Goldixan/USPAC/Photos/BlinkLEDCircuitFin.jpg

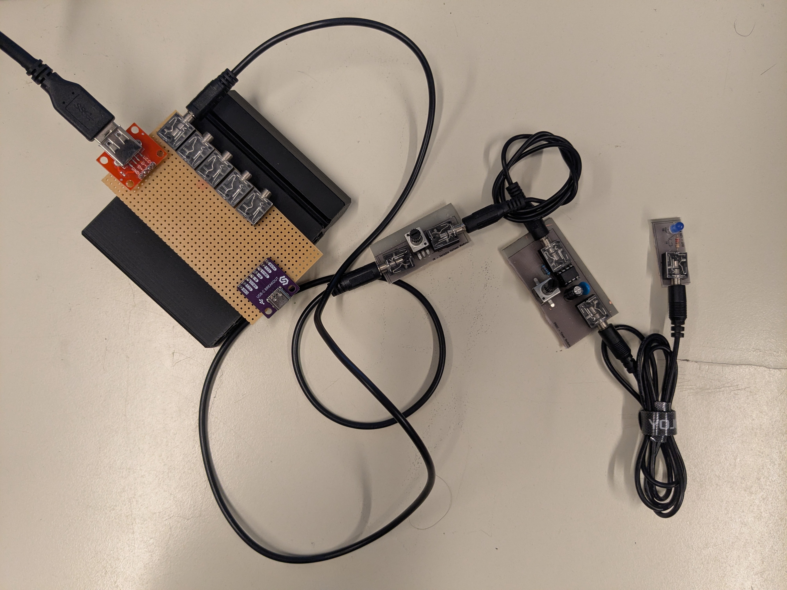
Photos/BlinkLEDCircuitFin.jpg
