Goldixan/USPAC/Photos/ALLES.jpg

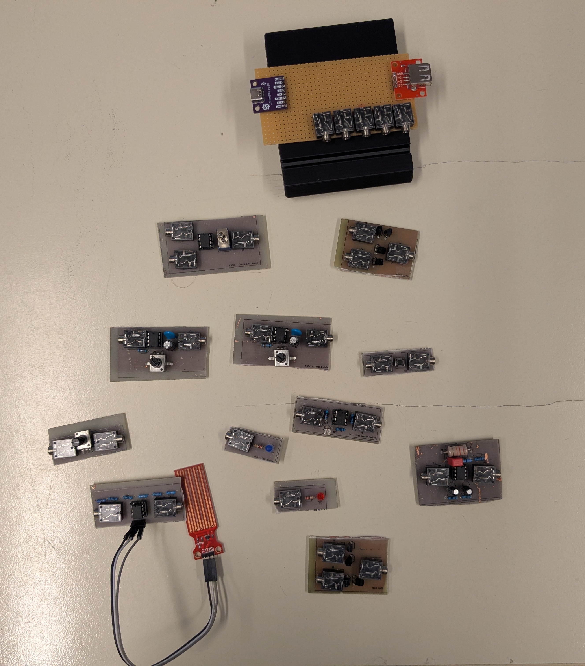
Photos/ALLES.jpg
