Goldixan/USPAC/Etching/etching_1.jpg

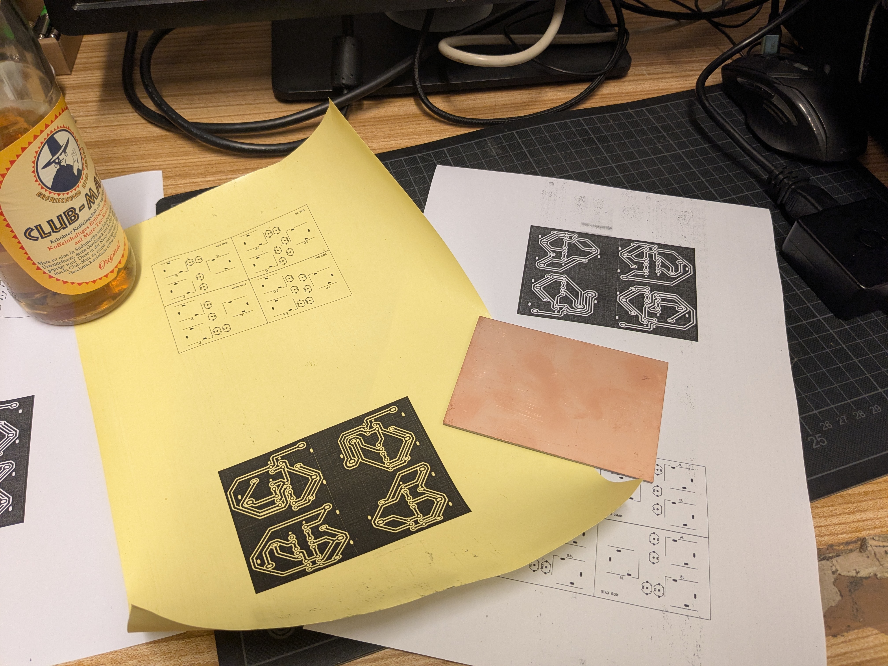
Etching/etching_1.jpg
