Goldixan/USPAC/Etching/etching_2.jpg

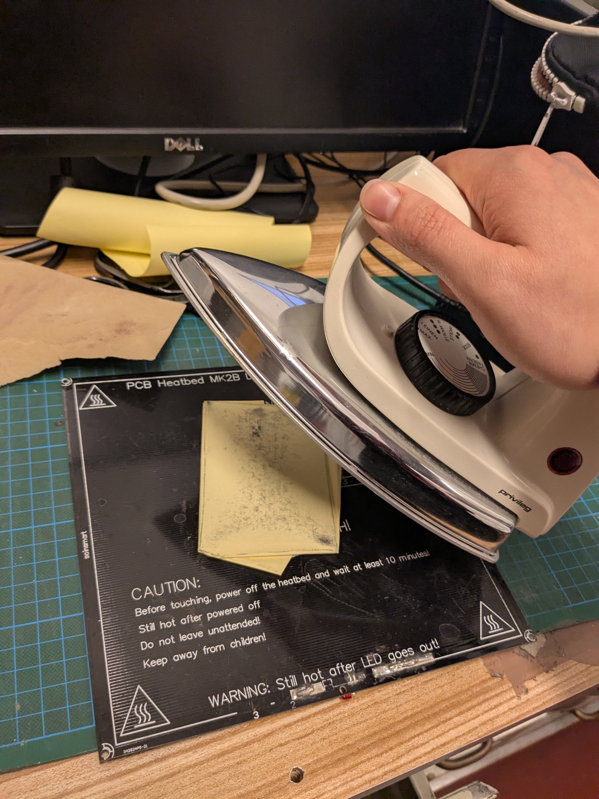
Etching/etching_2.jpg
