Goldixan/USPAC/Etching/etching_3.jpg

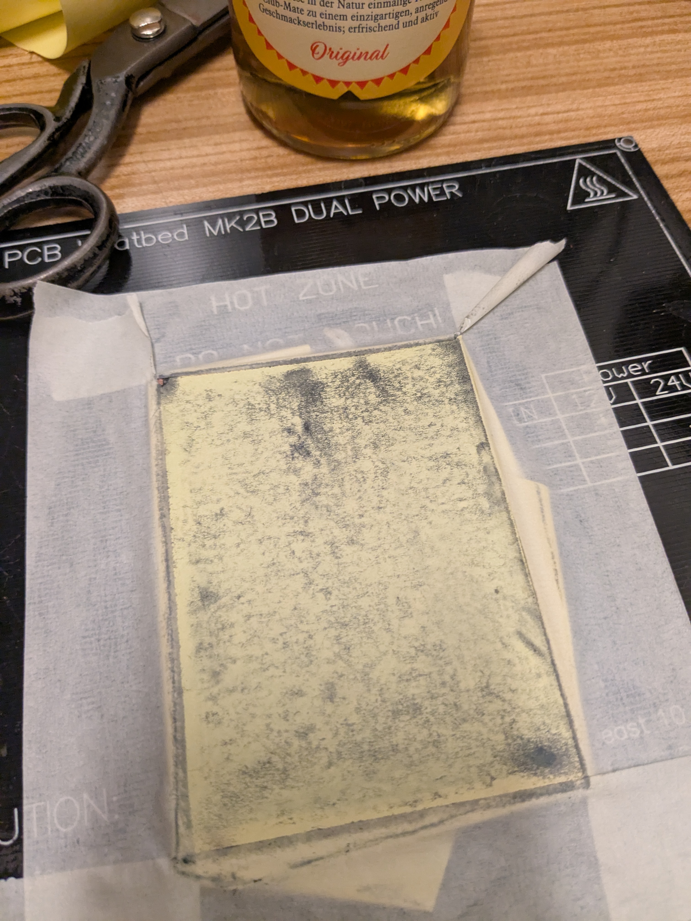
Etching/etching_3.jpg
