Goldixan/USPAC/Etching/etching_4.jpg

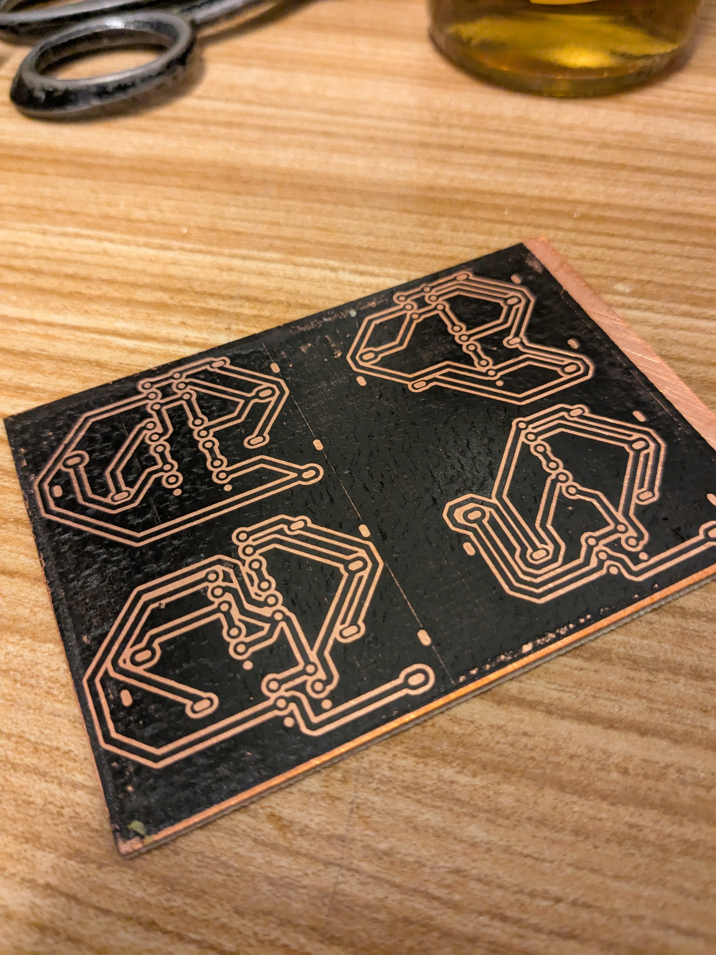
Etching/etching_4.jpg
