Goldixan/USPAC/Etching/etching_5.jpg

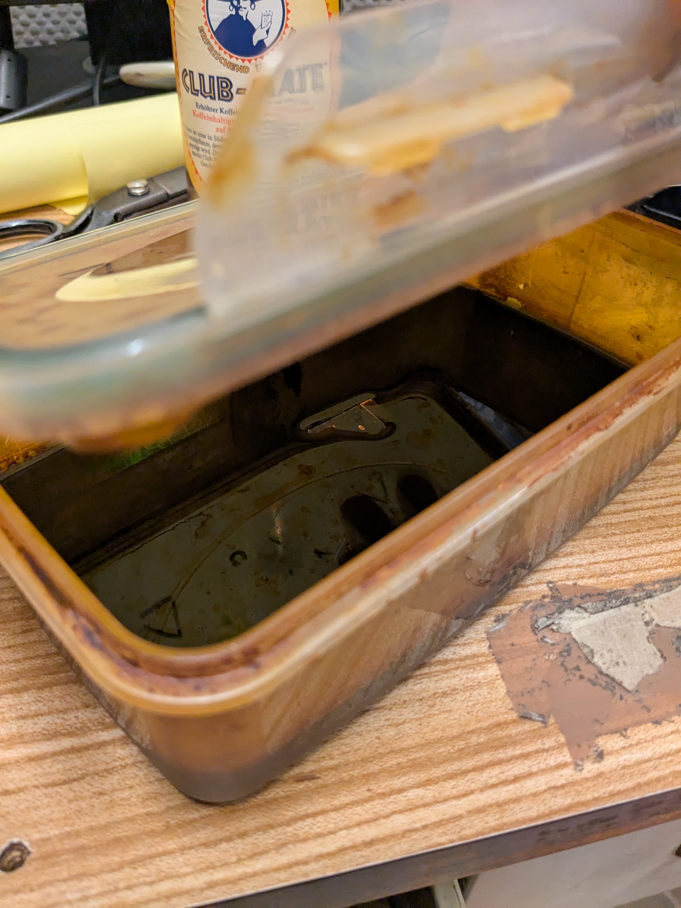
Etching/etching_5.jpg
