Goldixan/USPAC/Etching/etching_6.jpg

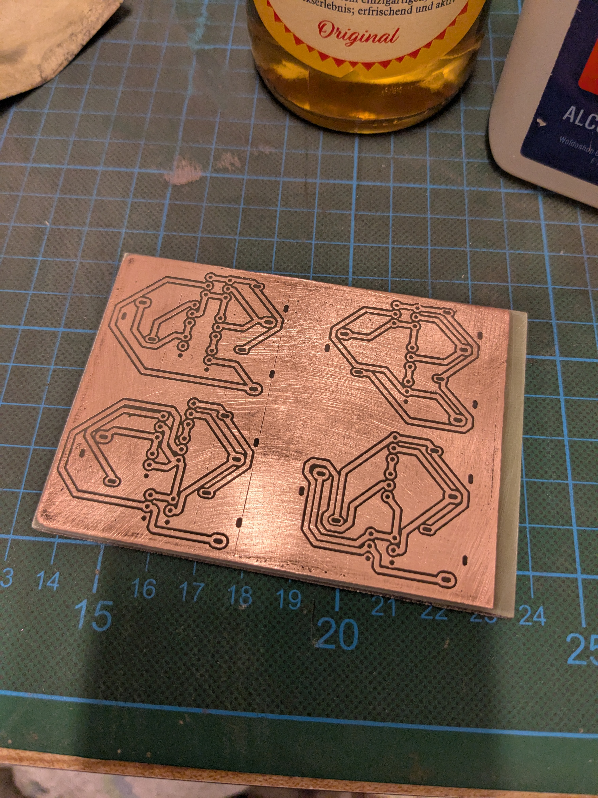
Etching/etching_6.jpg
