Goldixan/USPAC/Etching/etching_7.jpg

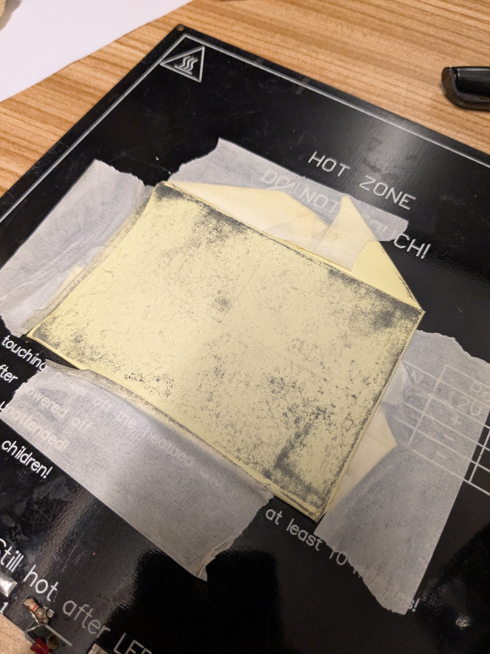
Etching/etching_7.jpg
