Goldixan/USPAC/Etching/etching_8.jpg

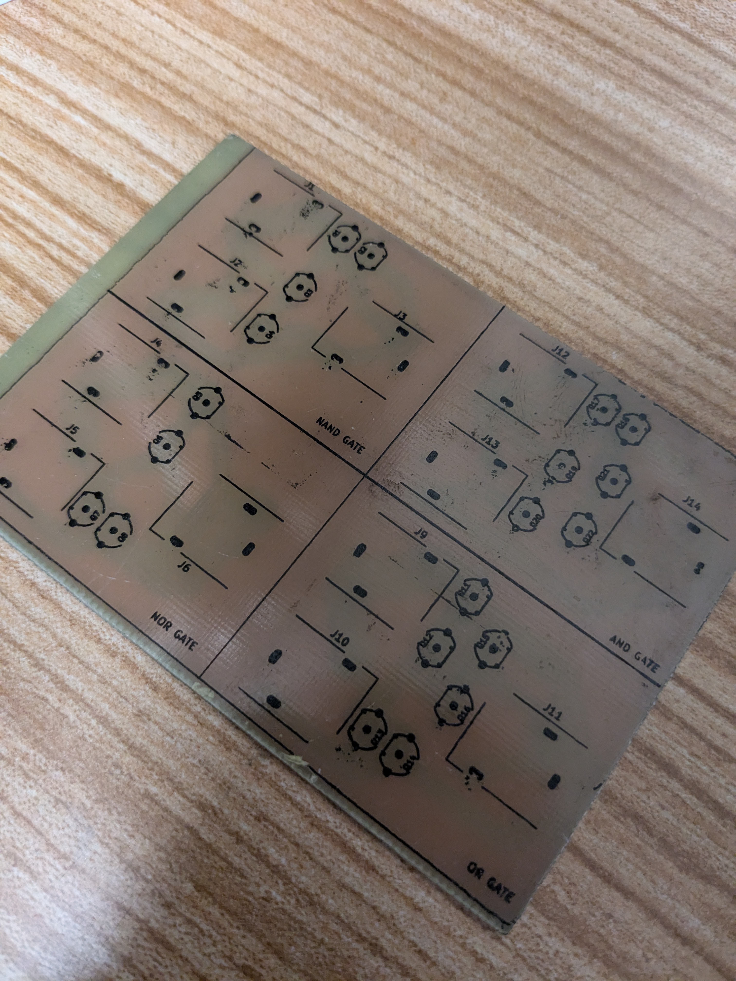
Etching/etching_8.jpg
