Goldixan/USPAC/Etching/etching_9.jpg

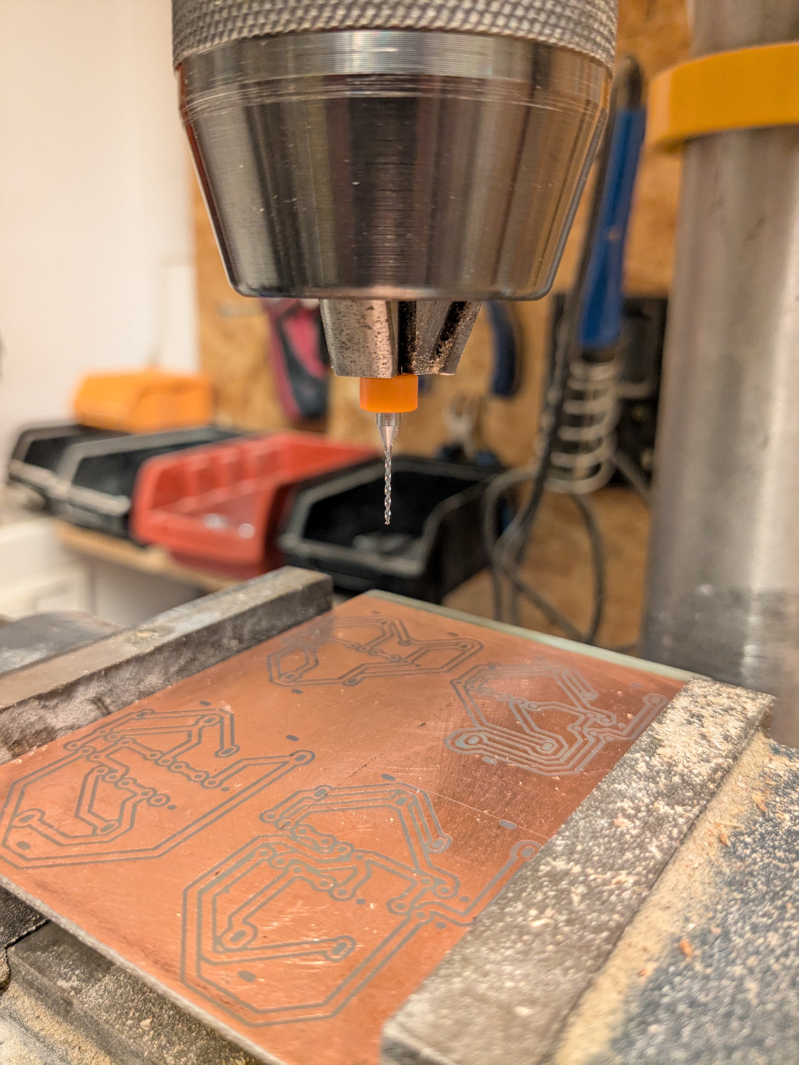
Etching/etching_9.jpg
