Goldixan/USPAC/Etching/etching_10.jpg

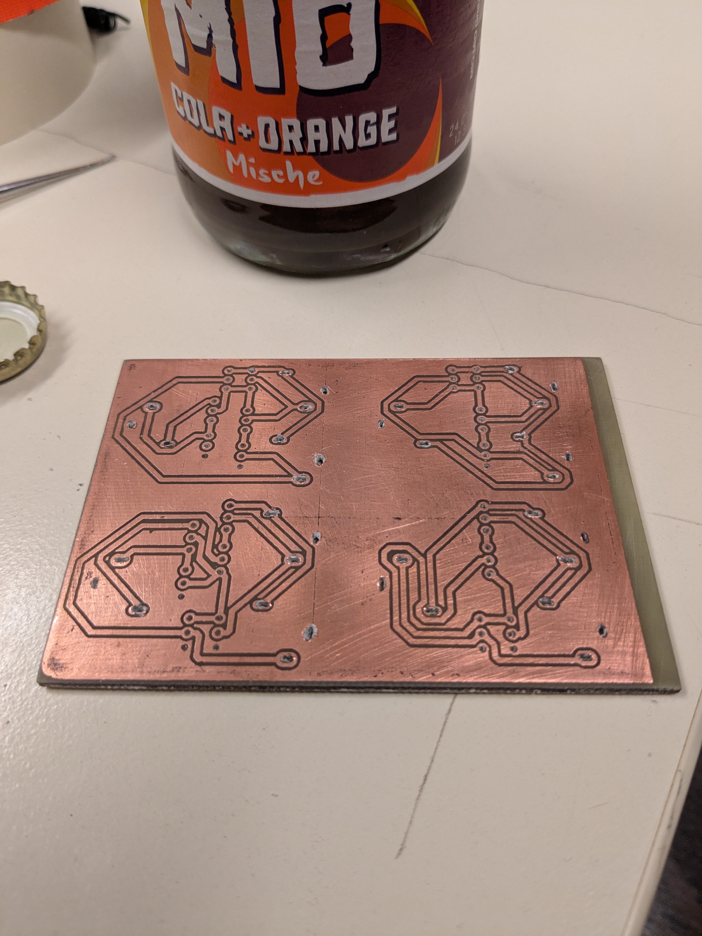
Etching/etching_10.jpg
