Goldixan/USPAC/Photos/Banana.jpg

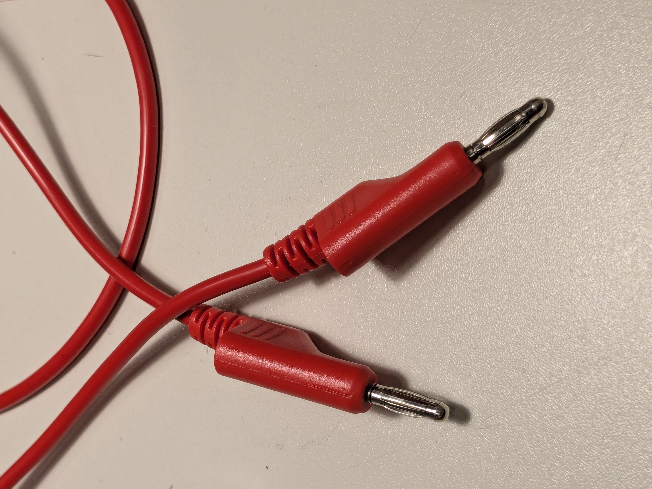
Photos/Banana.jpg
