Goldixan/USPAC/Shematics/IN/INPUT - Variable Voltage Module.png

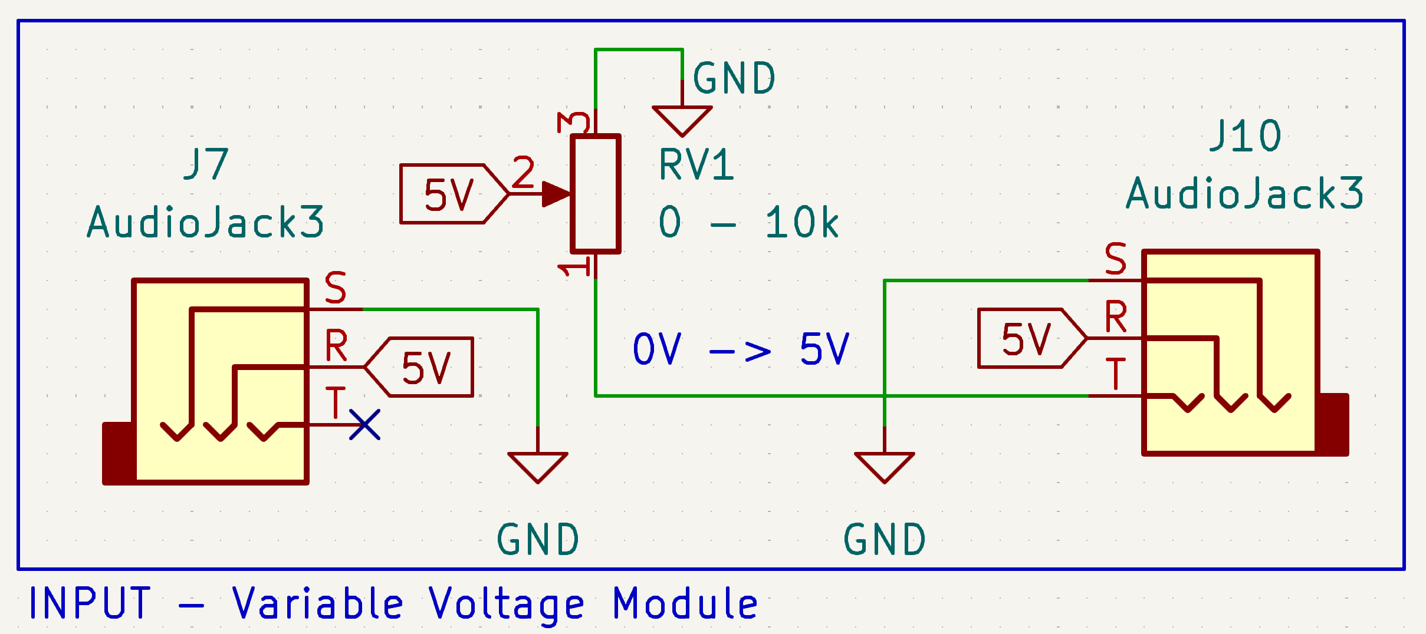
Shematics/IN/INPUT - Variable Voltage Module.png
