Goldixan/USPAC/Shematics/IN/WaterlevelSensor.png

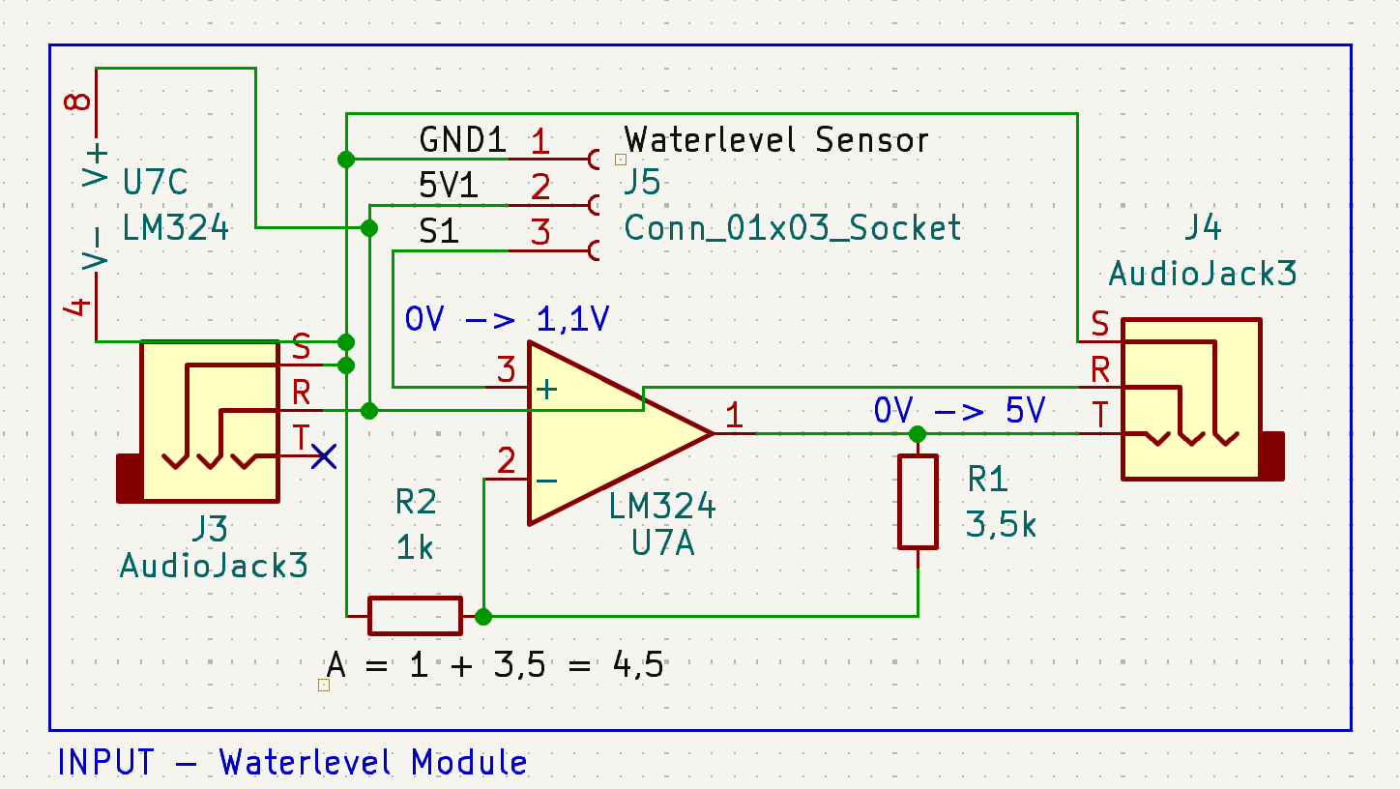
Shematics/IN/WaterlevelSensor.png
