Goldixan/USPAC/Shematics/OUT/OUT - Speaker Module.png

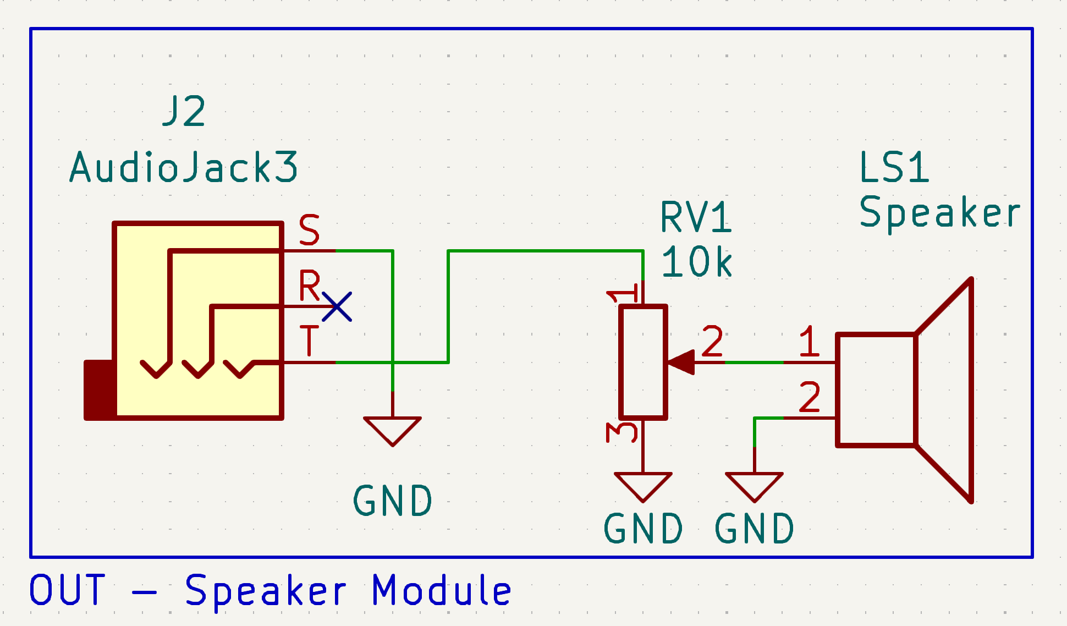
Shematics/OUT/OUT - Speaker Module.png
