Goldixan/USPAC/Shematics/PROC/Comparator Module.PNG

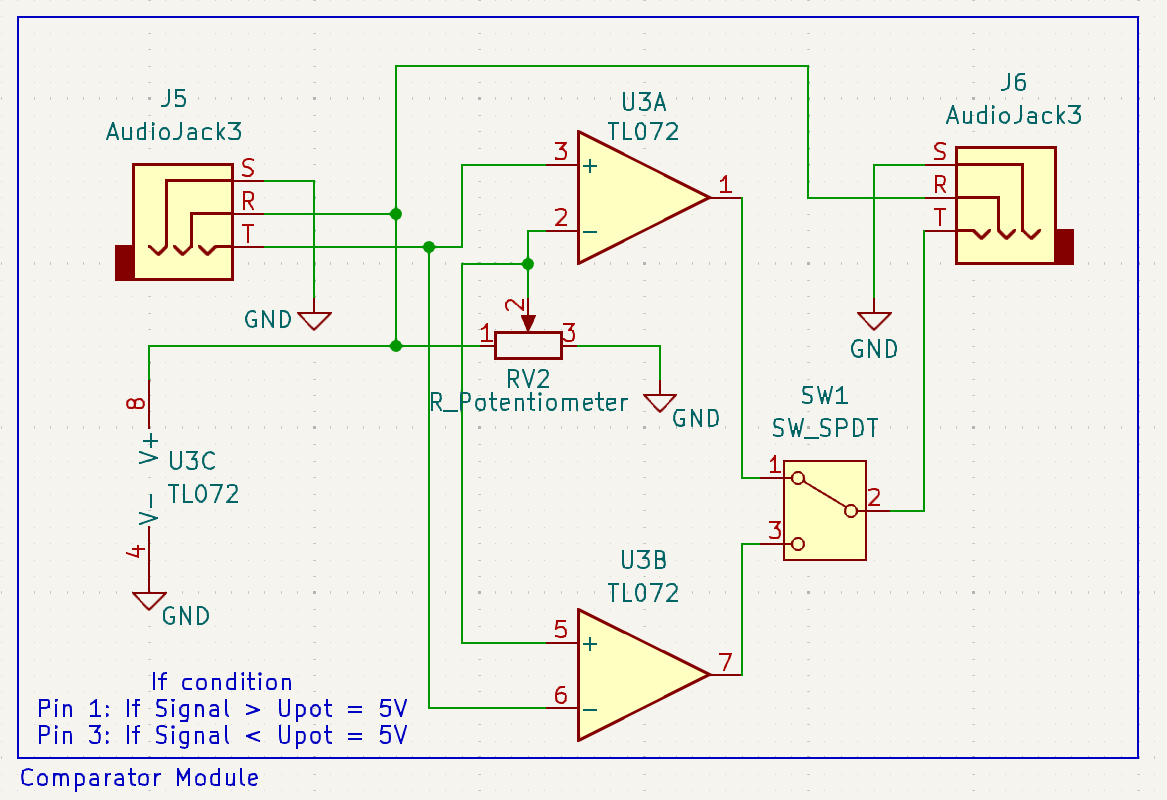
Shematics/PROC/Comparator Module.PNG
