Goldixan/USPAC/Shematics/PROC/PROC - AC to DC Module.png

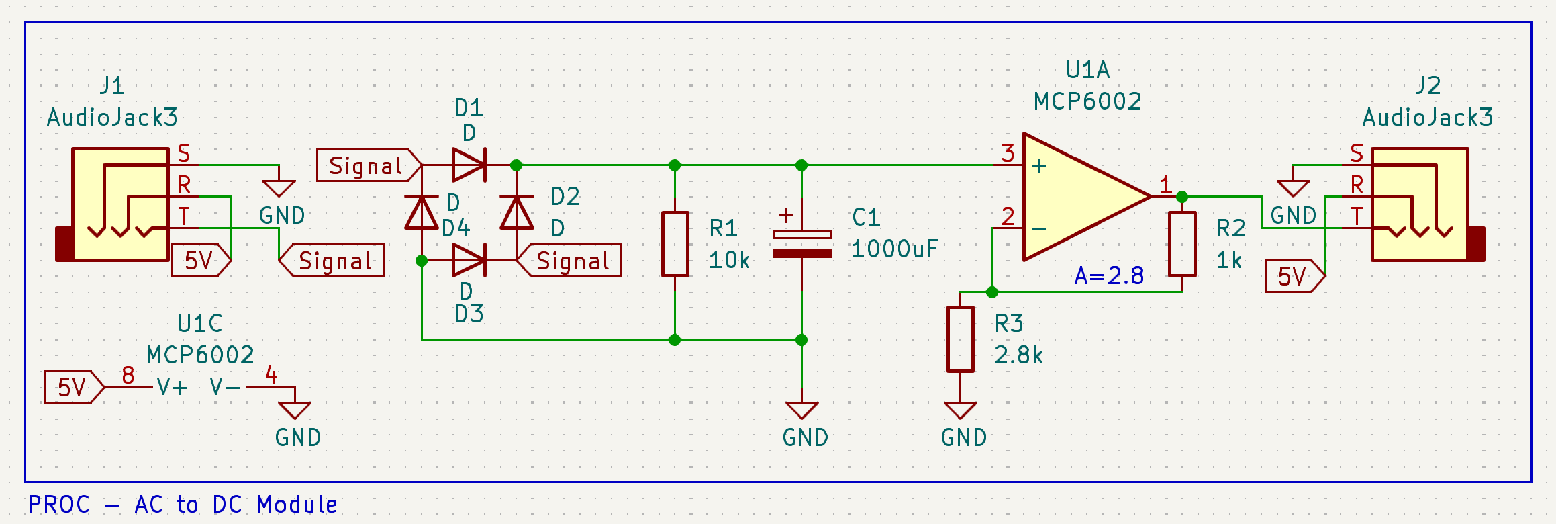
Shematics/PROC/PROC - AC to DC Module.png
