Goldixan/USPAC/Shematics/PROC/PROC - Comparator Module.png

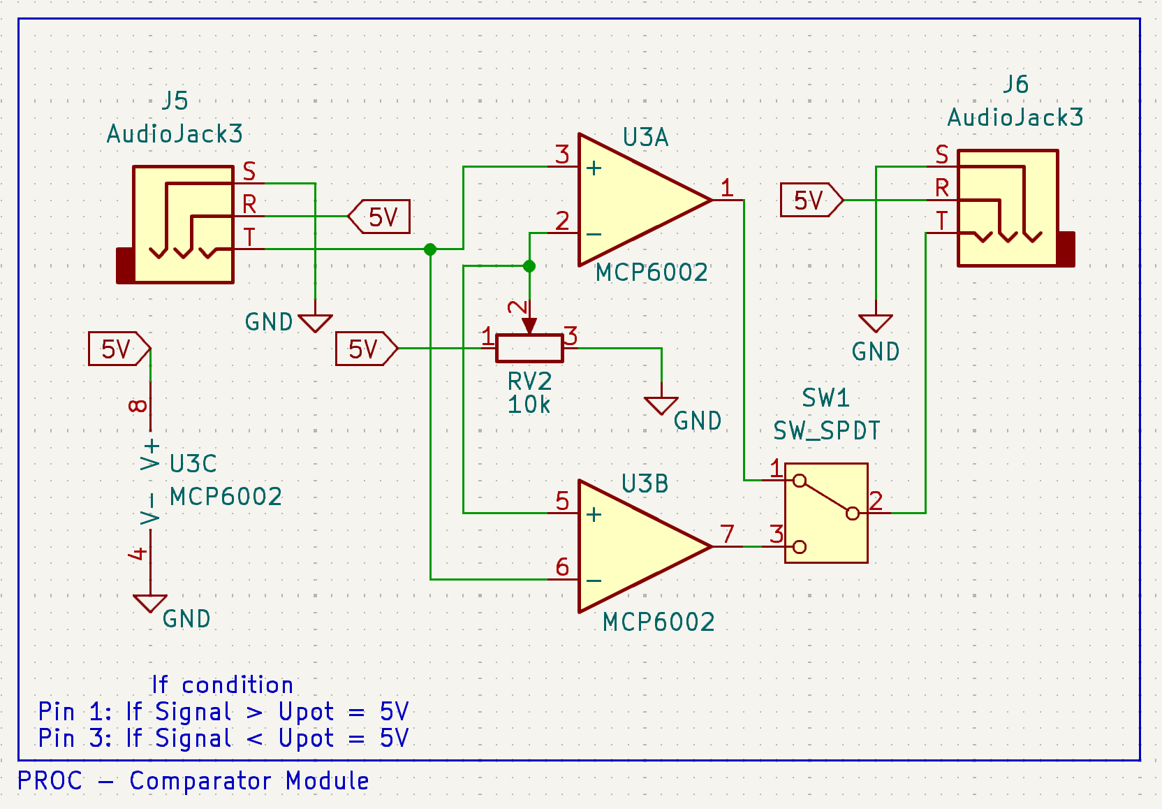
Shematics/PROC/PROC - Comparator Module.png
