Goldixan/USPAC/Shematics/PROC/PROC - Comparator Module_fixed.png

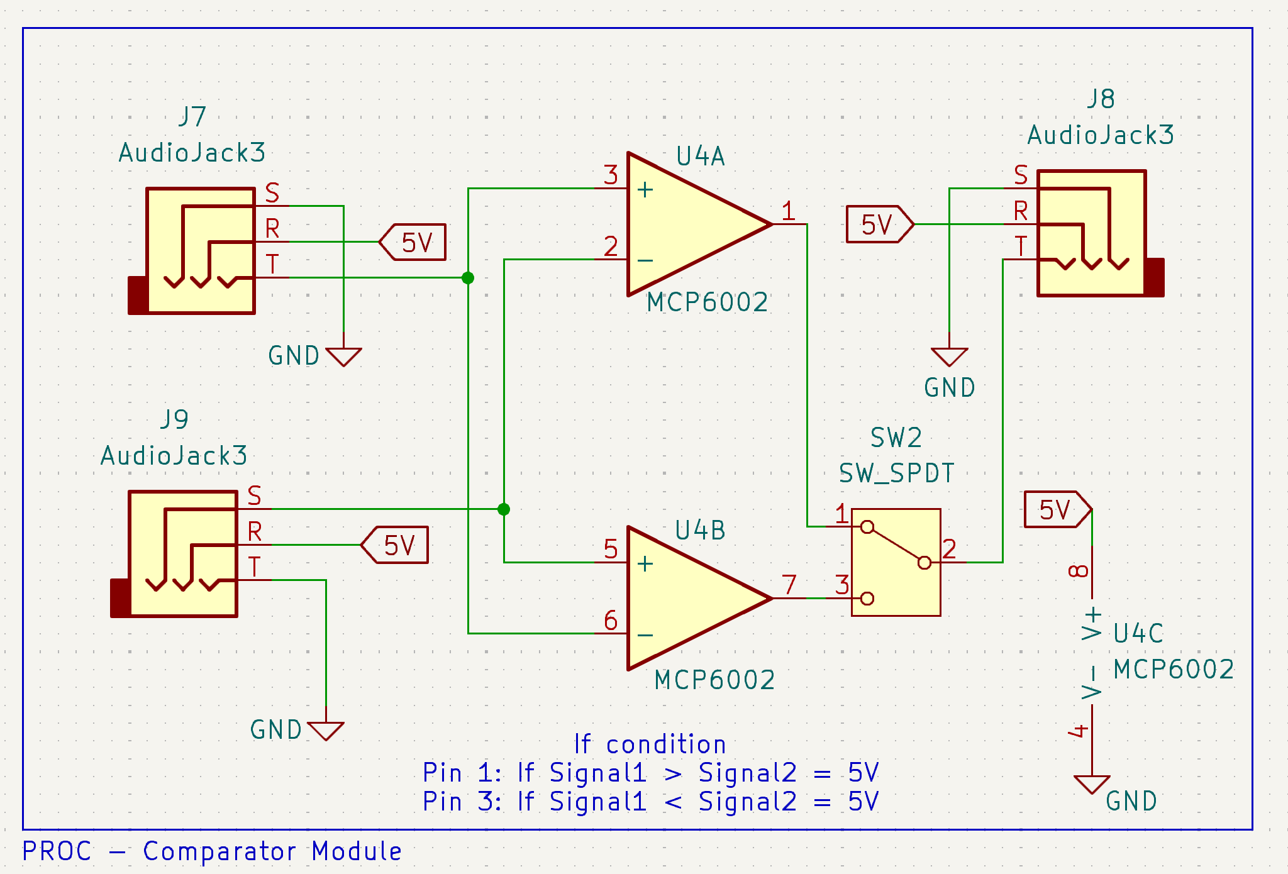
Shematics/PROC/PROC - Comparator Module_fixed.png
