Goldixan/USPAC/Shematics/PROC/PROC - Timer Module.png

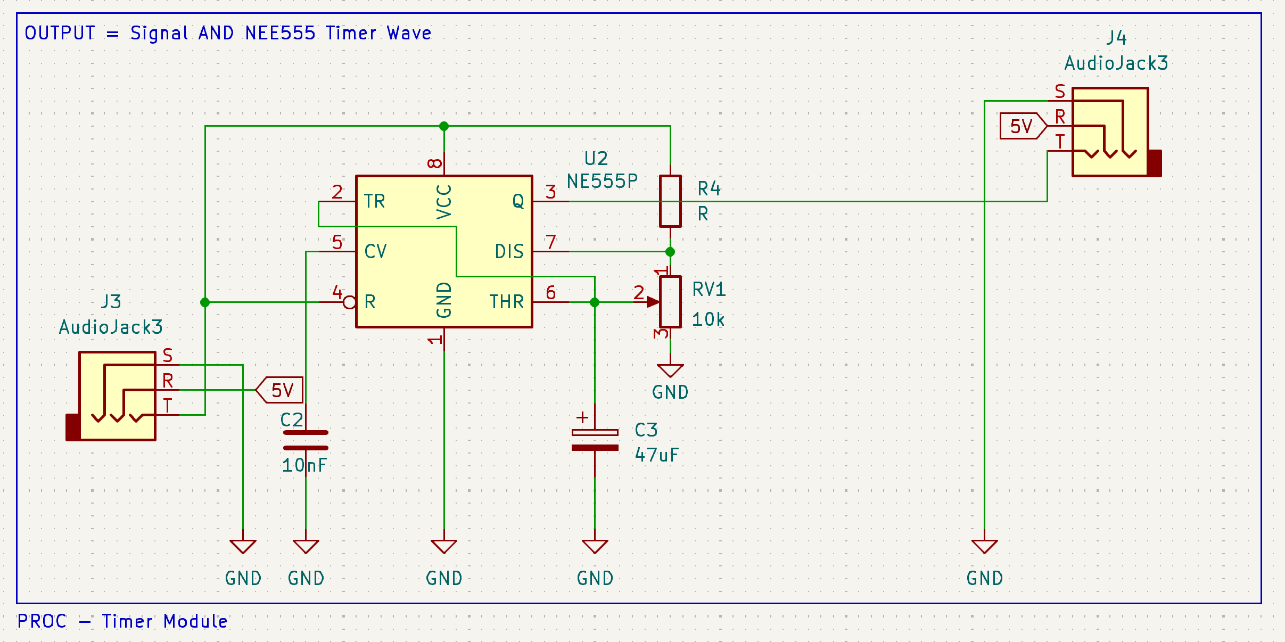
Shematics/PROC/PROC - Timer Module.png
