Goldixan/USPAC/Shematics/PROC/PROC - Timer Module_fixed2.png

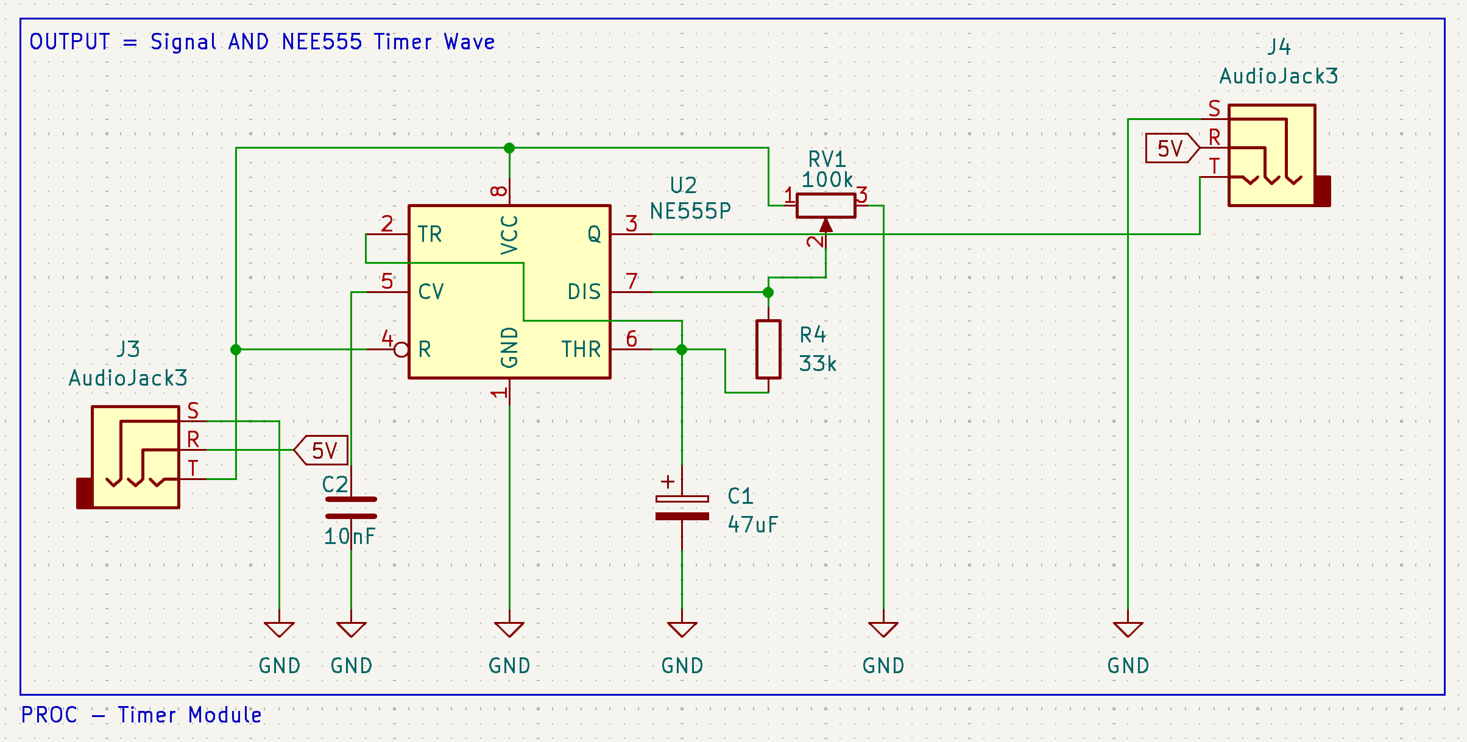
Shematics/PROC/PROC - Timer Module_fixed2.png
