Goldixan/USPAC/LTSpice Simulations/JFET VCR/Draft1.asc

J1: njf
R1: res; 500
V1: voltage; 5
V2: voltage; -5
Named nets: 0, VOUT
.tran 1
