Goldixan/USPAC/LTSpice Simulations/LC Schwingkreis mit Messbrücke/Draft1.asc

C1: cap; 2.2µF
C3: polcap; 1000µF
D1: diode
D2: diode
D3: diode
D4: diode
L1: ind; 100mH
R2: res; 10k
V1: voltage; SINE(0 2.5 50)
Named nets: 0, out
.tran 1
.ic v(out)=1
