Goldixan/USPAC/LTSpice Simulations/LC Schwingkreis mit Messbrücke/Draft2.asc

C1: polcap; 47µF
C2: cap; 10nF
R1: res; 100
R2: res; 33k
R3: res; 10
U1: NE555
V1: voltage; 5
Named nets: 0
.tran 10
