Goldixan/USPAC/LTSpice Simulations/NE555/Draft2.asc

C1: polcap; 47µF
C2: cap; 10nF
R1: res; 100
R2: res; 33k
R3: res; 100k
U1: NE555
V1: voltage; SINE(0 5 1)
Named nets: 0
.tran 10
