Goldixan/USPAC/LTSpice Simulations/CMOS/Inverter/Inverter.asc

M1: nmos
M2: pmos
V1: voltage; 1
V2: voltage; PULSE(0 1 0 0 0 20m 40m)
Named nets: 0
.tran 200m
PMOS must be mirrored and rotated by 180, Drain and Source are WRONG otherwise
