Goldixan/USPAC/LTSpice Simulations/CMOS/NOR/Draft1.asc

M1: pmos
M2: nmos
M3: pmos
M4: nmos
V1: voltage; PULSE(0 1 0 0 0 20m 40m)
V2: voltage; PULSE(0 1 20m 0 0 20m 40m)
V3: voltage; 1
Named nets: 0, OUT, X1, X2
.tran 200m
