Goldixan/USPAC/KiCadSchematics/PROC/Verarbeitung/Verarbeitung.kicad_pcb

## KiCad design KiCadSchematics/PROC/Verarbeitung/Verarbeitung.kicad_pcb (2026-04-08)

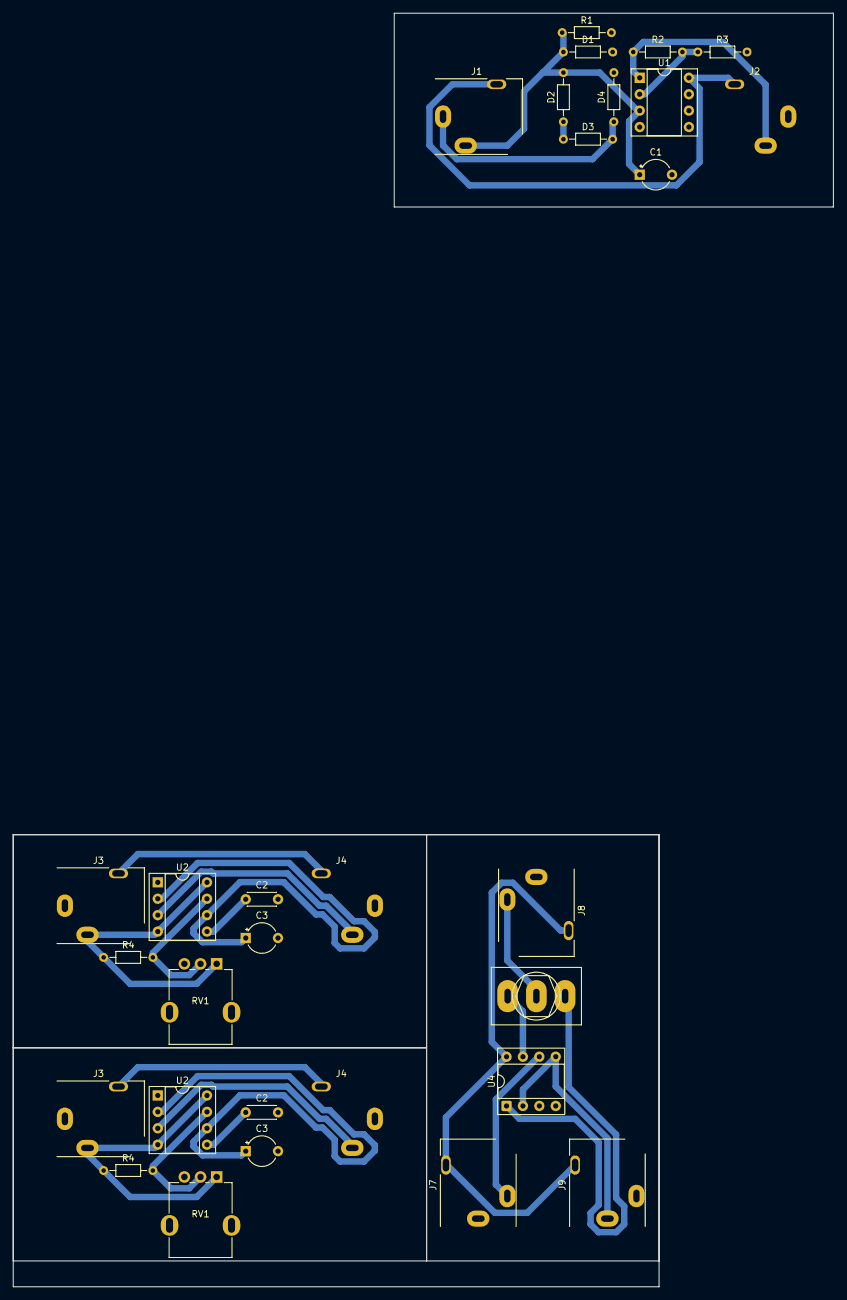
[picture p51: board Verarbeitung.kicad_pcb from above]

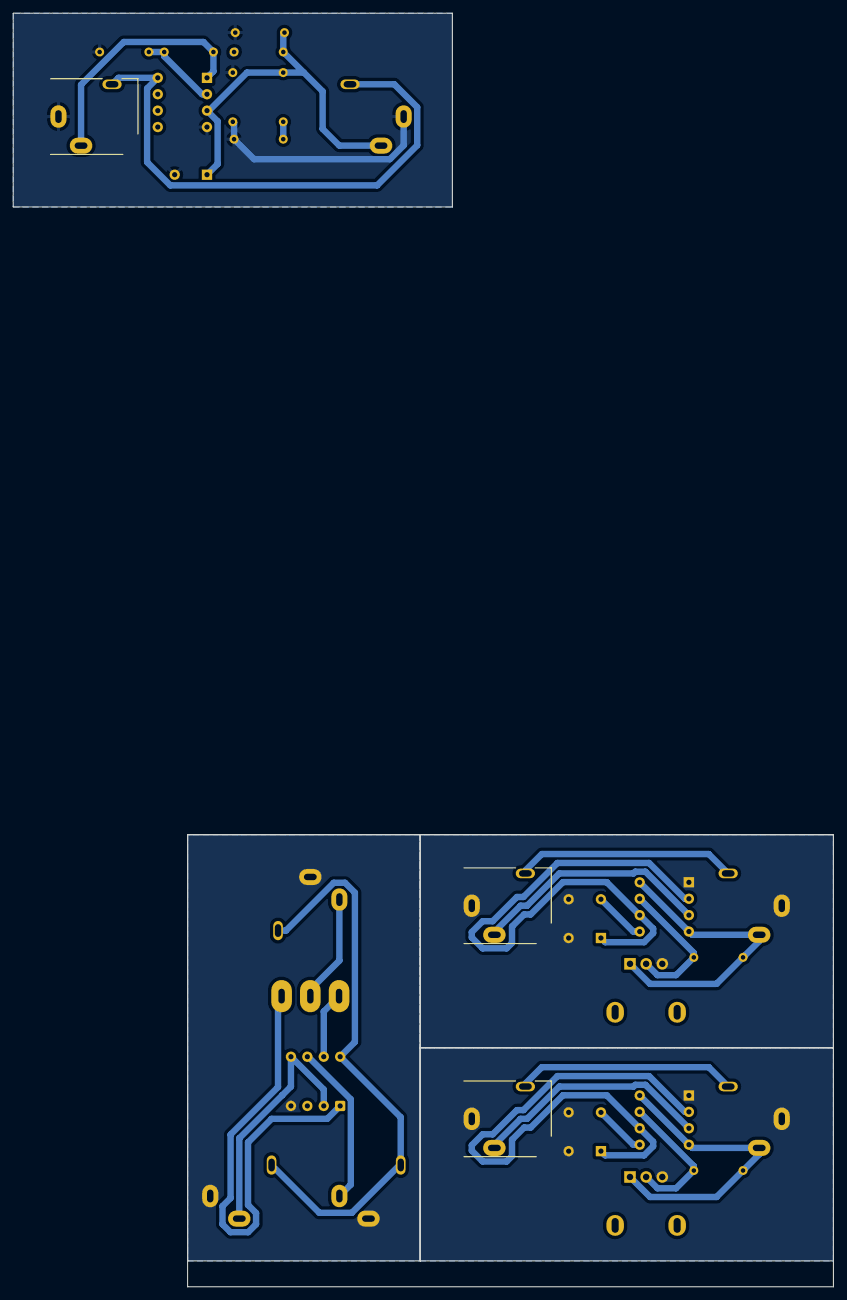
[picture p52: board Verarbeitung.kicad_pcb from below]

Board: 2 copper layers, 127.0 x 197.2 mm, 30 parts (3 on the bottom side), 17 nets.

Parts:
C1: 1000uF; CP_Radial_Tantal_D4.5mm_P5.00mm
C2, C2#2: 10nF; C_Disc_D4.3mm_W1.9mm_P5.00mm
C3, C3#2: 47uF; CP_Radial_Tantal_D4.5mm_P5.00mm
D1, D2, D3, D4: D; R_Axial_DIN0204_L3.6mm_D1.6mm_P7.62mm_Horizontal
J1, J2, J3, J3#2, J4, J4#2, J7, J8, J9: AudioJack3; Jack_3.5mm_CUI_SJ1-3513N_Horizontal
R1: 10k; R_Axial_DIN0204_L3.6mm_D1.6mm_P7.62mm_Horizontal
R2: 1k; R_Axial_DIN0204_L3.6mm_D1.6mm_P7.62mm_Horizontal
R3: 2.8k; R_Axial_DIN0204_L3.6mm_D1.6mm_P7.62mm_Horizontal
R4, R4#2: R; R_Axial_DIN0204_L3.6mm_D1.6mm_P7.62mm_Horizontal
RV1, RV1#2: 100k; Potentiometer_RV09
SW2: SW_SPDT; SW_Toggle_Blue_wSlots
U1, U4: MCP6002; DIP-8_W7.62mm_Socket
U2, U2#2: NE555P; DIP-8_W7.62mm_Socket

Connections:
5V: J1.R, J2.R, J7.R, J8.R, J9.R, U1.8 (V+), U4.8 (V+)
GND: C1.2, C2.2, C2#2.2, C3.2, C3#2.2, D3.2 (A), D4.2 (A), J1.S, J2.S, J3.S, J3#2.S, J4.S, J4#2.S, J7.S, J8.S, J9.T, R1.2, R3.2, RV1.3, RV1#2.3, U1.4 (V-), U2.1 (GND), U2#2.1 (GND), U4.4 (V-)
unnamed: C1.1, D1.1 (K), D2.1 (K), R1.1, U1.3 (+)
unnamed: J2.T, R2.1, U1.1
unnamed: J3.R, J3#2.R, J4.R, J4#2.R
unnamed: SW2.1 (A), U4.1
unnamed: J8.T, SW2.2 (B)
unnamed: SW2.3 (C), U4.7
unnamed: R2.2, R3.1, U1.2 (-)
unnamed: C2.1, C2#2.1, U2.5 (CV), U2#2.5 (CV)
unnamed: R4.2, R4#2.2, RV1.2, RV1#2.2, U2.7 (DIS), U2#2.7 (DIS)
unnamed: J4.T, J4#2.T, U2.3 (Q), U2#2.3 (Q)
unnamed: J3.T, J3#2.T, R4.1, R4#2.1, RV1.1, RV1#2.1, U2.4 (R), U2.8 (VCC), U2#2.4 (R), U2#2.8 (VCC)
unnamed: C3.1, C3#2.1, U2.2 (TR), U2.6 (THR), U2#2.2 (TR), U2#2.6 (THR)
unnamed: J7.T, U4.3 (+), U4.6 (-)
unnamed: J9.S, U4.2 (-), U4.5 (+)
Signal: D1.2 (A), D2.2 (A), D3.1 (K), D4.1 (K), J1.T
