Goldixan/USPAC/KiCadSchematics/PROC/Logikgatter/Logikgatter.kicad_pcb

## KiCad design KiCadSchematics/PROC/Logikgatter/Logikgatter.kicad_pcb (2026-04-08)

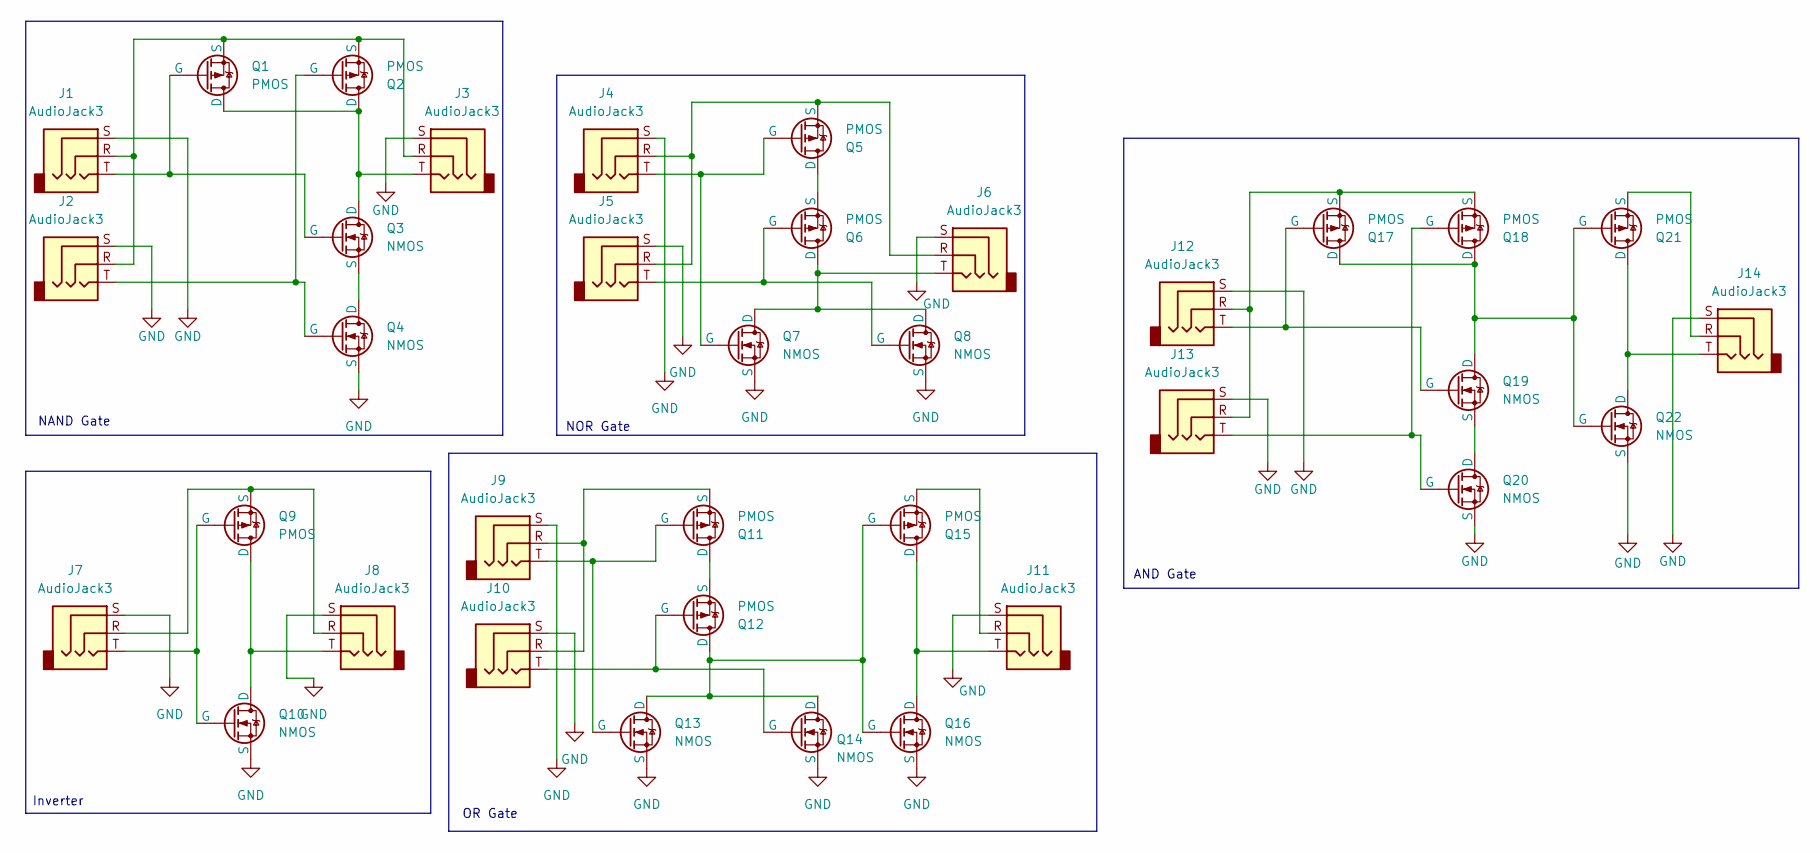
[picture p53: schematic Logikgatter.kicad_sch]

Parts:
J1, J2, J3, J4, J5, J6, J7, J8, J9, J10, J11, J12, J13, J14: AudioJack3; Jack_3.5mm_CUI_SJ1-3513N_Horizontal
Q1, Q2, Q5, Q6, Q9, Q11, Q12, Q15, Q17, Q18, Q21: PMOS; SOT54ES
Q3, Q4, Q7, Q8, Q10, Q13, Q14, Q16, Q19, Q20, Q22: NMOS; SOT54ES

Connections:
GND: J1.S, J2.S, J3.S, J4.S, J5.S, J6.S, J7.S, J8.S, J9.S, J10.S, J11.S, J12.S, J13.S, J14.S, Q4.3 (S), Q7.3 (S), Q8.3 (S), Q10.3 (S), Q13.3 (S), Q14.3 (S), Q16.3 (S), Q20.3 (S), Q22.3 (S)
unnamed: J3.T, Q1.1 (D), Q2.1 (D), Q3.1 (D)
unnamed: J1.T, Q1.2 (G), Q3.2 (G)
unnamed: J1.R, J2.R, J3.R, Q1.3 (S), Q2.3 (S)
unnamed: J2.T, Q2.2 (G), Q4.2 (G)
unnamed: Q3.3 (S), Q4.1 (D)
unnamed: Q5.1 (D), Q6.3 (S)
unnamed: J4.T, Q5.2 (G), Q7.2 (G)
unnamed: J4.R, J5.R, J6.R, Q5.3 (S)
unnamed: J6.T, Q6.1 (D), Q7.1 (D), Q8.1 (D)
unnamed: J5.T, Q6.2 (G), Q8.2 (G)
unnamed: J7.R, J8.R, Q9.3 (S)
unnamed: J8.T, Q9.1 (D), Q10.1 (D)
unnamed: J7.T, Q9.2 (G), Q10.2 (G)
unnamed: Q11.1 (D), Q12.3 (S)
unnamed: J9.T, Q11.2 (G), Q13.2 (G)
unnamed: J9.R, J10.R, Q11.3 (S)
unnamed: Q12.1 (D), Q13.1 (D), Q14.1 (D), Q15.2 (G), Q16.2 (G)
unnamed: J10.T, Q12.2 (G), Q14.2 (G)
unnamed: J11.T, Q15.1 (D), Q16.1 (D)
unnamed: J11.R, Q15.3 (S)
unnamed: Q17.1 (D), Q18.1 (D), Q19.1 (D), Q21.2 (G), Q22.2 (G)
unnamed: J12.T, Q17.2 (G), Q19.2 (G)
unnamed: J12.R, J13.R, Q17.3 (S), Q18.3 (S)
unnamed: J13.T, Q18.2 (G), Q20.2 (G)
unnamed: Q19.3 (S), Q20.1 (D)
unnamed: J14.T, Q21.1 (D), Q22.1 (D)
unnamed: J14.R, Q21.3 (S)

Notes on the sheet:
NOR Gate
OR Gate
Inverter
NAND Gate
AND Gate

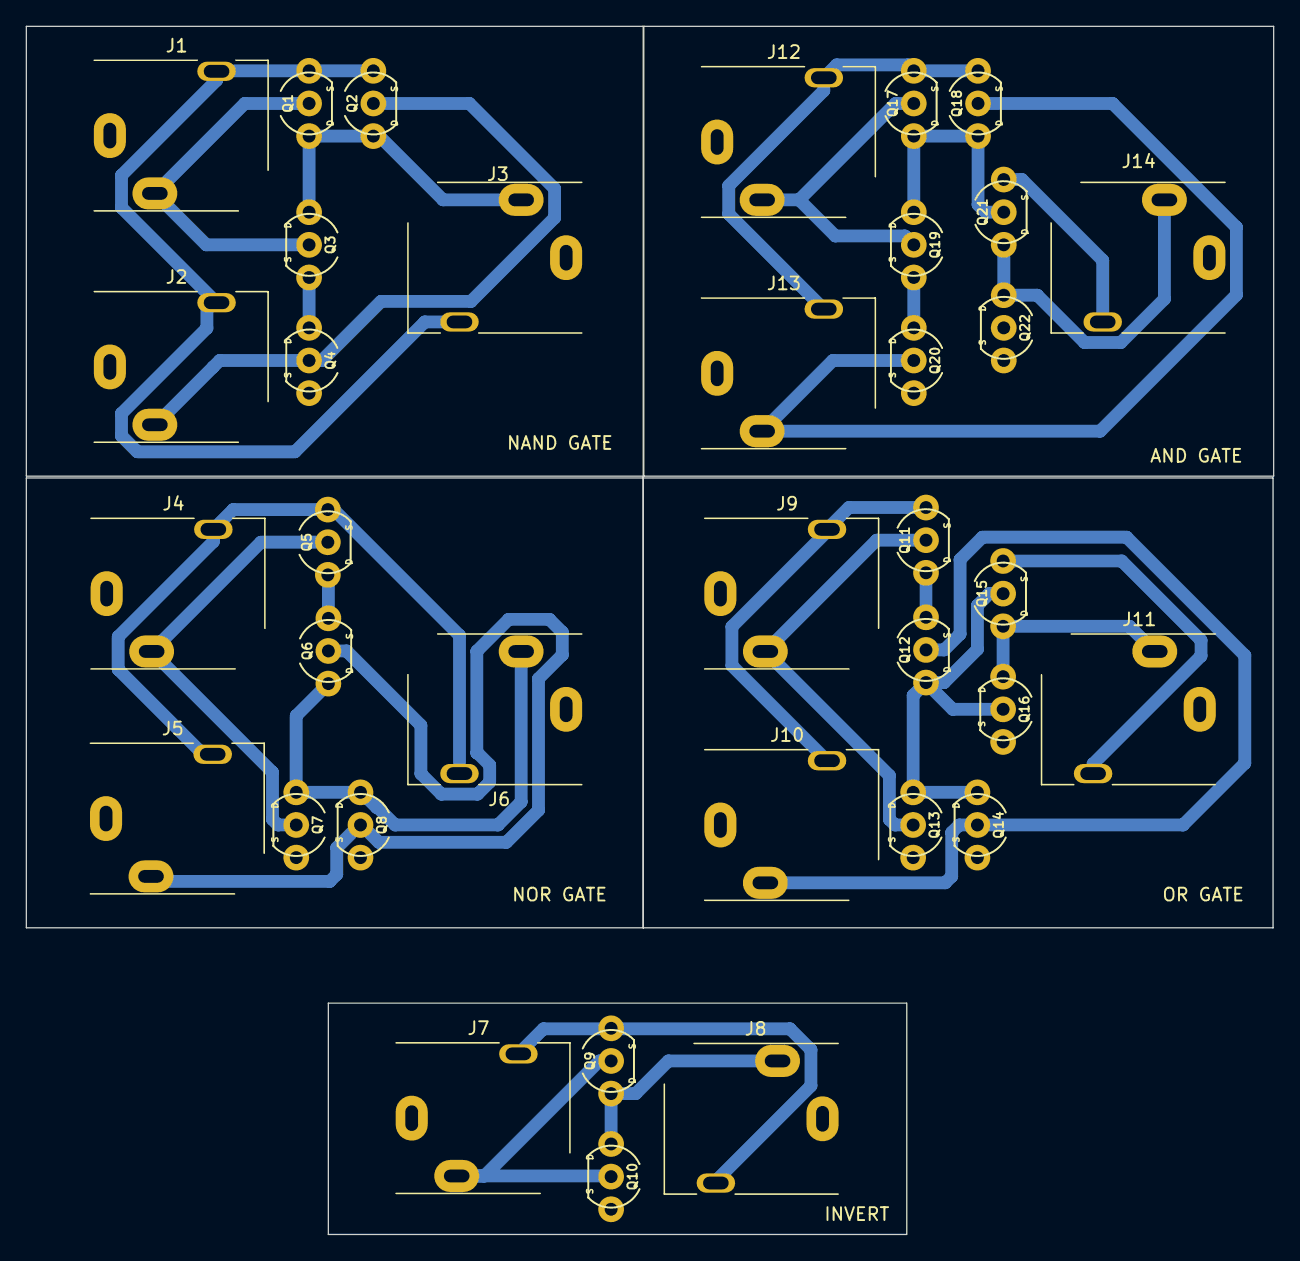
[picture p54: board Logikgatter.kicad_pcb from above]

Board: 2 copper layers, 97.1 x 94.0 mm, 36 parts (0 on the bottom side), 28 nets.
