Goldixan/USPAC/KiCadSchematics/OUT/Output/Output.kicad_pcb

## KiCad design KiCadSchematics/OUT/Output/Output.kicad_pcb (2026-04-08)

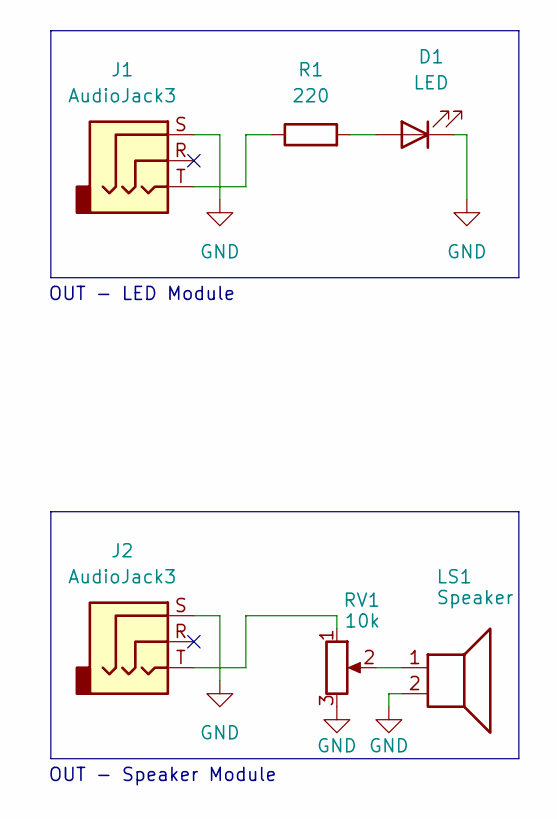
[picture p55: schematic Output.kicad_sch]

Parts:
D1: LED; LED_D3.0mm
J1, J2: AudioJack3; Jack_3.5mm_CUI_SJ1-3513N_Horizontal
LS1: Speaker; R_Axial_DIN0204_L3.6mm_D1.6mm_P7.62mm_Horizontal
R1: 220; R_Axial_DIN0204_L3.6mm_D1.6mm_P7.62mm_Horizontal
RV1: 10k; Potentiometer_RV09

Connections:
GND: D1.1 (K), J1.S, J2.S, LS1.2, RV1.3
unnamed: D1.2 (A), R1.2
unnamed: J1.T, R1.1
unnamed: J2.T, RV1.1
unnamed: LS1.1, RV1.2

Notes on the sheet:
OUT - LED Module
OUT - Speaker Module

Board: 2 copper layers, 6 parts (0 on the bottom side), 5 nets, no tracks yet.
